laomar/newwind/pcb/panel.xlsx

Comment | Designator | Footprint | Quantity
LED3绿 | D1 | LED-2P | 1 | 0.05
LED3黄 | D2 | LED-2P | 1 | 0.05
OLED1.3 | J1 | OLED | 1 | 20
XH2.54-12P | J2 | XH2.54-12P | 1 | 0.1
103 | R3,R4,R5,R6 | 0805 | 4 | 0.02
102 | R1, R2 | 0805 | 2 | 0.02
Up | S1 | SW-PB | 1 | 0.03
Down | S2 | SW-PB | 1 | 0.03
Ok | S3 | SW-PB | 1 | 0.03
Ret | S4 | SW-PB | 1 | 0.03
PCB |  |  | 1 | 3
 |  |  |  | 23.5
