laomar/newwind/pcb/sensor.xlsx

Comment | Designator | Footprint | Quantity
RJ45 | J1 | RJ-45 | 1 | 0.5
RJ45 | J2 | RJ-45 | 1 | 0.5
2EDG-3.81-4P | J3 | 2EDG-3.81-4P | 1 | 0.8
2EDG-3.81-6P | J4 | 2EDG-3.81-6P | 1 | 1.1
154/1W | R1, R2, R3 | 1W | 3 | 0.05
49R9 | R4, R5, R6, R7, R8, R9 | 0805 | 6 | 0.02
4R99 | R10, R11, R12, R13, R14, R15 | 0805 | 6 | 0.02
电压传感器 | S1, S2, S3 | US | 3 | 2.5
电流传感器1000:1 |  |  | 3 | 11
PCB |  |  | 1 | 3
 |  |  |  | 46.8
