laomar/newwind/pcb/newwind.xls

型号 | 序号 | 封装 | 数量 | 价格
HK3FF-DC5V-SHG | K1, K2, K3, K4, K5 | T73 | 5 | 1.1
1N4148W | D2, D3, D4, D5, D6 | 1206 | 5 | 0.03
自恢复保险1.5A | F1 | 1812 | 1 | 0.15
电池座+电池CR2032 | BT1 | CR2032 | 1 | 0.5
HQ05P10LRN | U4 | HIECUBE12W | 1 | 22
8.192M | Y3 | 49S | 1 | 0.2
10uF | C17, C18, C21 | 1206 | 3 | 0.35
10uH | L1, L2, L3 | 0805 | 3 | 0.05
14.7456M | Y1 | 49S | 1 | 0.2
15pF | C15, C16 | 0805 | 2 | 0.05
22pF | C1, C2 | 0805 | 2 | 0.05
32.768K | Y2 | 2*6 | 1 | 0.2
100uF | C23 | 1210 | 1 | 0.5
104 | R1 | 0805 | 1 | 0.02
102 | R4, R5, R6, R7, R8, R9, R12, R13, R14, R15, R17, R18, R19, R20, R21, R22, R23, R24, R25, R26, R27, R28,R29,R30 | 0805 | 24 | 0.02
103 | R2, R3 | 0805 | 2 | 0.02
104 | C3, C4, C5, C6, C7, C8, C9, C11, C12, C13, C19, C20, C22, C24,C37 | 0805 | 16 | 0.05
106 | R16 | 0805 | 1 | 0.02
121 | R10, R11 | 0805 | 2 | 0.02
333 | C25, C26, C27, C28, C29, C30, C31, C32, C33, C34, C35, C36 | 0805 | 12 | 0.06
1000uF | C10 | 13*20 | 1 | 1
1117-3.3 | U10 | SOT-223 | 1 | 0.5
8550 | Q1, Q2, Q3, Q4, Q5 | SOT-23-3 | 5 | 0.05
2EDG-3.81-5P | J5 | 2EDG-3.81-5P | 1 | 1
2EDG-3.81-2P | J4 | 2EDG-3.81-2P | 1 | 0.4
ATmega128A-AU | U1 | ATMega128 | 1 | 12
DC | J7 | 5.5*2.5 | 1 | 0.15
DS1302ZN | U2 | SOP-8P | 1 | 2
RJ45座 | J9,J8 | RJ-45 | 2 | 0.5
DC3-10P | J10 | DC3-10P | 1
单排针8P | J1 | CON8 | 1 | 0.15
MAX13487E | U5, U6 | SOP-8P | 2 | 4
P82B96TD | U7 | SOP-8P | 1 | 4
XH2.54-12P | J2 | XH2.54-12P | 1 | 0.1
LED3红 | D1 | LED-2P | 1 | 0.05
RN8302B | U8 | QFP-44P | 1 | 7
2EDG-3.81-7P | J6,J3 | 2EDG-3.81-7P | 2 | 1.3
SHT3X | U3 | SHT3X | 1 | 25
SMBJ6.8CA | D7, D8, D9, D10,D11,D12 | SMB | 6 | 0.2
SHT30 |  |  | 1 | 36
XH2.54排线 |  |  | 1 | 2.2
排母2P | U3 | 2P | 1 | 0.1
排母4P | U3 | 4P | 1 | 0.1
PCB |  |  | 1 | 7
 |  |  |  | 154.5
