laomar/newwind/pcb/newwind.pdf

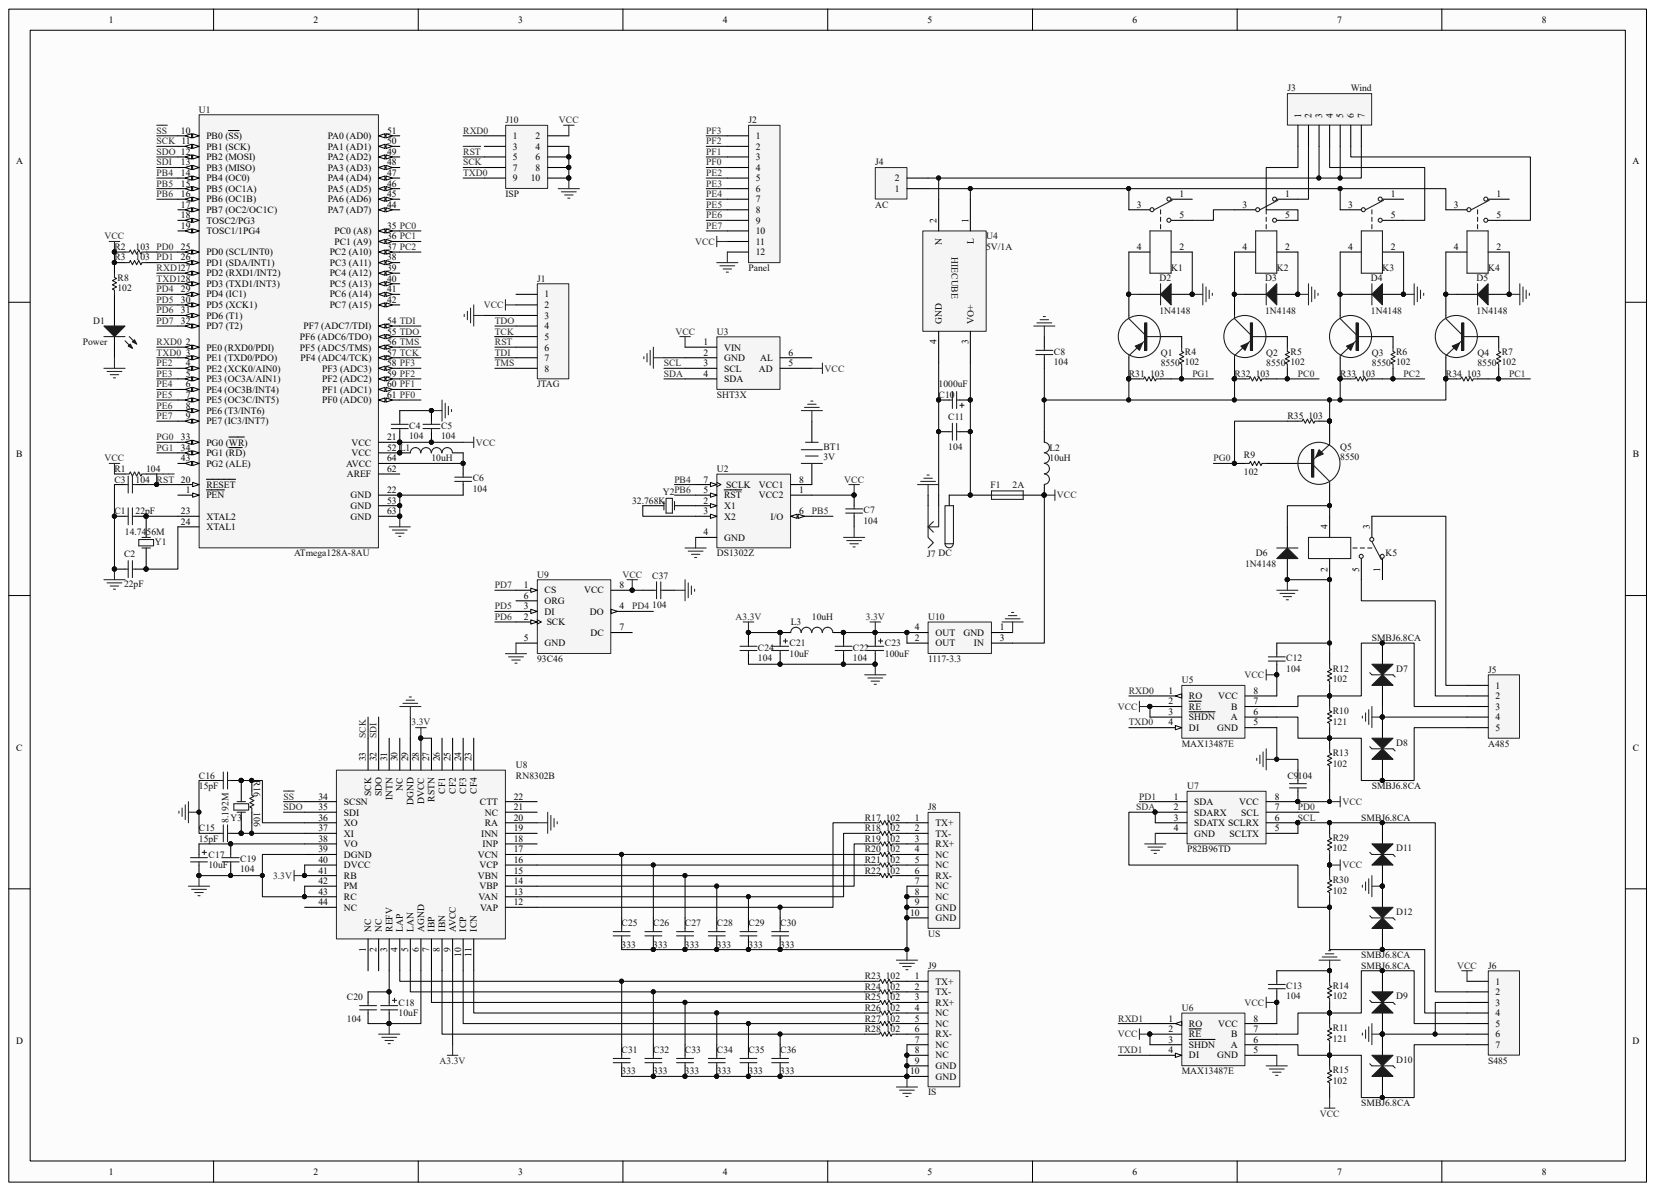
[picture p1: page 1]
