laomar/newwind/pcb/panel.pdf

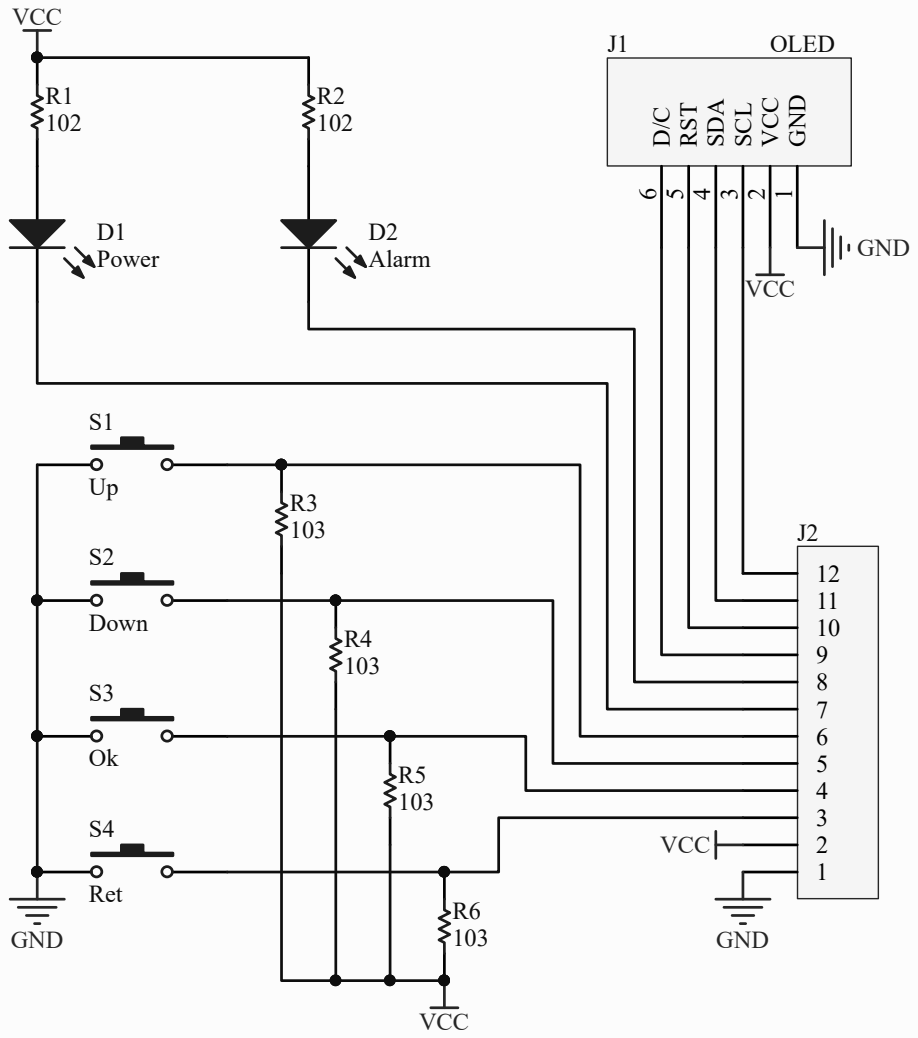
[picture p2: page 1]
