laomar/newwind/pcb/sensor.pdf

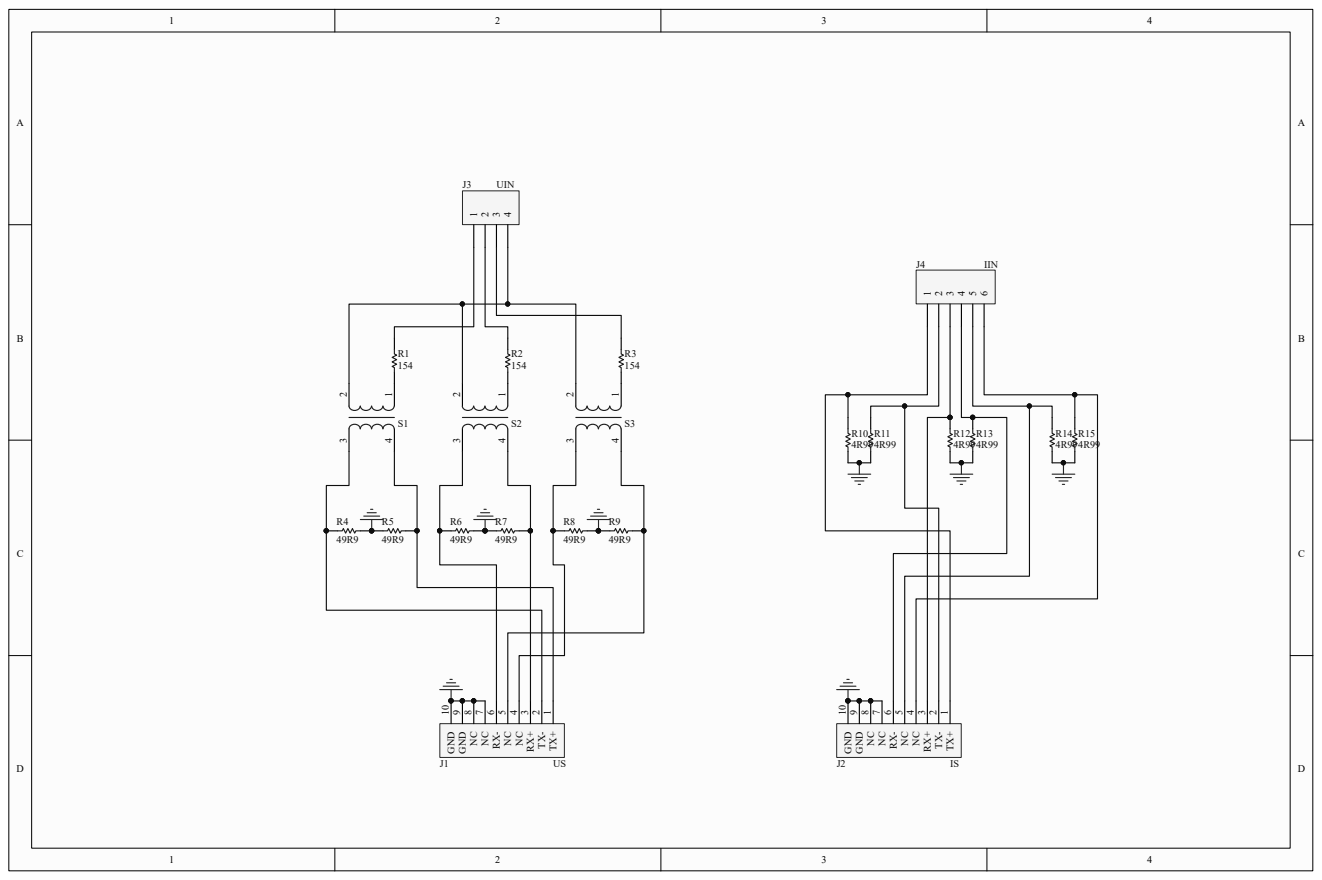
[picture p3: page 1]
