laomar/newwind/(list of files, drawings)

Other design files:
pcb/newwind.PcbDoc
pcb/newwind.PrjPCB
pcb/newwind.SchDoc
pcb/panel.PcbDoc
pcb/panel.PrjPCB
pcb/panel.SchDoc
pcb/sensor.PcbDoc
pcb/sensor.PrjPCB
pcb/sensor.SchDoc
